mdshihab56/NodeMCU-open-source-IoT-Plant-Environment-Management-System-with-Web-Android-Desktop-interfaces./Images/WINDOWS APP UI.png

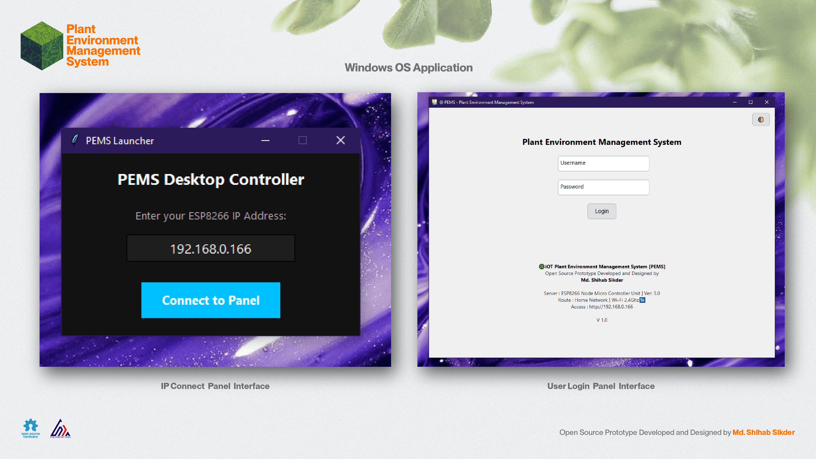
Images/WINDOWS APP UI.png
