mdshihab56/NodeMCU-open-source-IoT-Plant-Environment-Management-System-with-Web-Android-Desktop-interfaces./Images/TOP AND BOTTOM LATER PCB.png

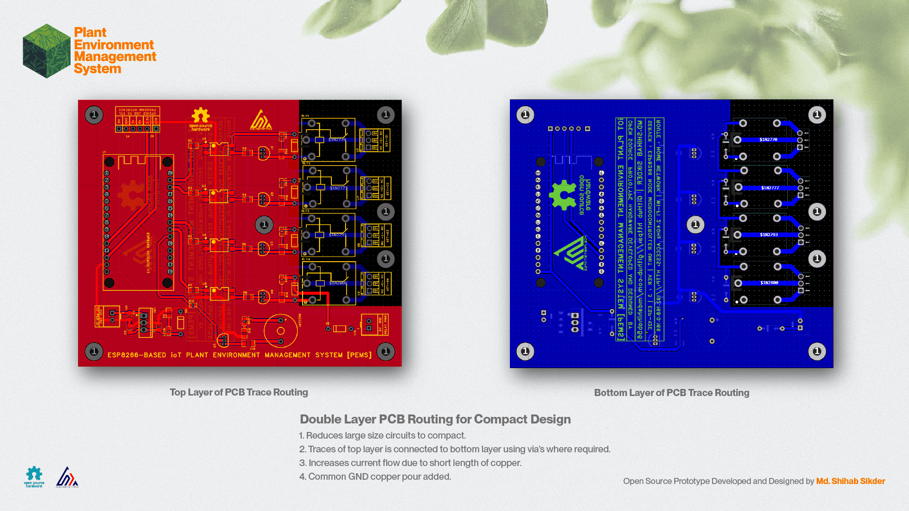
Images/TOP AND BOTTOM LATER PCB.png
