mdshihab56/NodeMCU-open-source-IoT-Plant-Environment-Management-System-with-Web-Android-Desktop-interfaces./README.md

# IoT Plant Environment Management System [PEMS]
PEMS Resperitory template

An ESP8266-based IoT automation prototype designed for smart plant environment control using a responsive web dashboard and real-time relay management.

## Overview

PEMS (Plant Environment Management System) is an open-source IoT project that combines embedded systems, web technologies, and environmental automation into a single platform.

The system allows users to control plant lighting, water supply, and environmental activation devices directly from a browser over Wi-Fi using an ESP8266 NodeMCU.
## Features
1. Login-protected Web Dashboard
2. Dark / Light Mode UI
3. ESP8266 Async Web Server
4. Dual Plant Light Control
5. Water Supply Control
6. Air Humidifier Control
7. Buzzer Feedback System
8. Responsive Minimal UI
9. Local Network Browser Access
10. Real-time Relay Switching

### Hardware
1. ESP8266 NodeMCU
2. 4-Channel opto-isolated Relay Design
3. Active Buzzer
4. Wi-Fi Network

### Programming Languages
1. Arduino C++
2. HTML
3. CSS
4. JavaScript
5. ESPAsyncWebServer Library

## Android Application
To improve accessibility and user experience, a dedicated Android application was developed for the PEMS ecosystem. The mobile application allows users to:
1. Connect directly to the ESP8266 local server
2. Access the control dashboard without manually typing the IP address
3. Control environmental modules remotely through a simplified mobile interface
4. Improve usability for daily plant monitoring operations
The Android application acts as a lightweight remote controller for the IoT system over a local Wi-Fi network.

## Windows Desktop Application
A standalone Windows desktop application was also developed using Python for desktop-based monitoring and control.

### Desktop Application Features
1. Quick access to the ESP8266 dashboard
2. Simplified desktop interaction
3. Faster local device management
4. Lightweight executable (.exe) application
5. No browser dependency required

## Programs used
1. Python
2. GUI-based desktop interface
3. Executable packaging for Windows systems
The desktop application was designed to provide a more convenient control environment for long-term monitoring and testing purposes.

## Multi-Platform Ecosystem
PEMS now supports multiple control platforms:

| Platform | Function |
|---|---|
| Web Dashboard | Browser-based Control |
| Android App | Mobile Access |
| Windows Application | Desktop Monitoring |
| ESP8266 Server | Core IoT Controller |
This creates a flexible multi-platform IoT ecosystem for smart environmental management.

## ESP8266 NodeMCU Pinout
ESP8266 PINOUT

## Circuit Schematic Diagram
SCHEMATICS

## Top and Bottom Layer PCB Designing
TOP AND BOTTOM LATER PCB

## PCB 2D View
PCB 2D VIEW

## USB to TTL Interface Header
USB TO TTL

## Web UI in Desktop Browser
WEB IP UI

## Web UI Activation Dashboard in Desktop Browser
WEB IP UI_ACTIVATION SYSTEM

## Windows App UI
WINDOWS APP UI

## Android Mobile App UI
MOBILE APP UI

## Web, PC, and Android App also in Black Theme by Toggle the Moon Icon
WEB, PC and MOBILE APP black theme UI

## Future Expansion Goals
Planned future developments include:
1. Real-time sensor analytics
2. Cloud connectivity
3. MQTT communication
4. Notification system
5. AI-assisted automation
6. Historical environmental data logging
7. Cross-platform synchronization
8. OTA firmware updates
9. Smart scheduling system
10. Mobile push notifications

# Project Vision
The goal of PEMS is to evolve into a scalable smart environmental management ecosystem capable of integrating embedded systems, automation, responsive web technologies, desktop software, and mobile applications into a unified IoT platform.
