mdshihab56/NodeMCU-open-source-IoT-Plant-Environment-Management-System-with-Web-Android-Desktop-interfaces./Android Apk/Preview/MOBILE APP UI.png

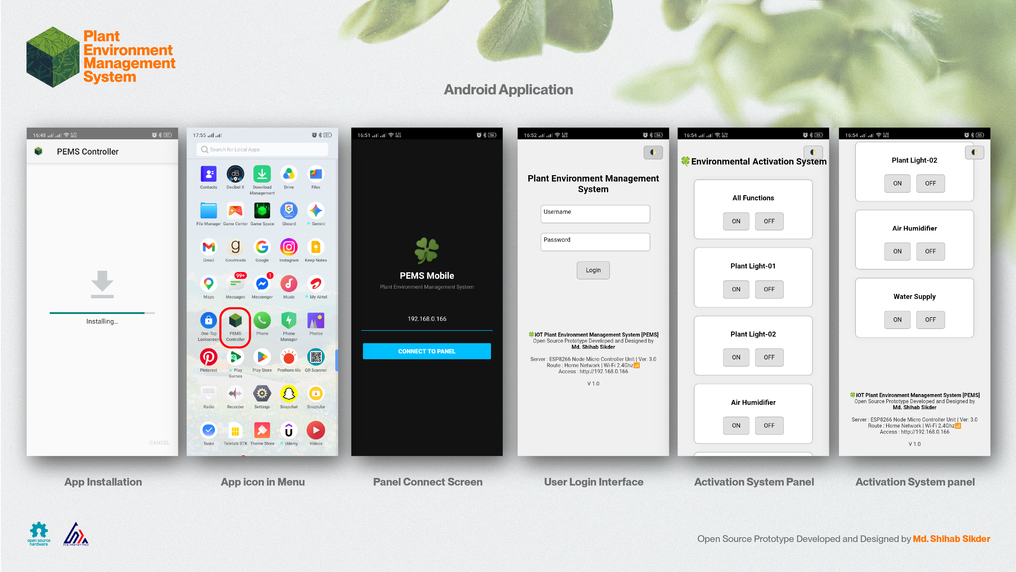
Android Apk/Preview/MOBILE APP UI.png
