mdshihab56/NodeMCU-open-source-IoT-Plant-Environment-Management-System-with-Web-Android-Desktop-interfaces./Circuit Schematic/SCHEMATICS.png

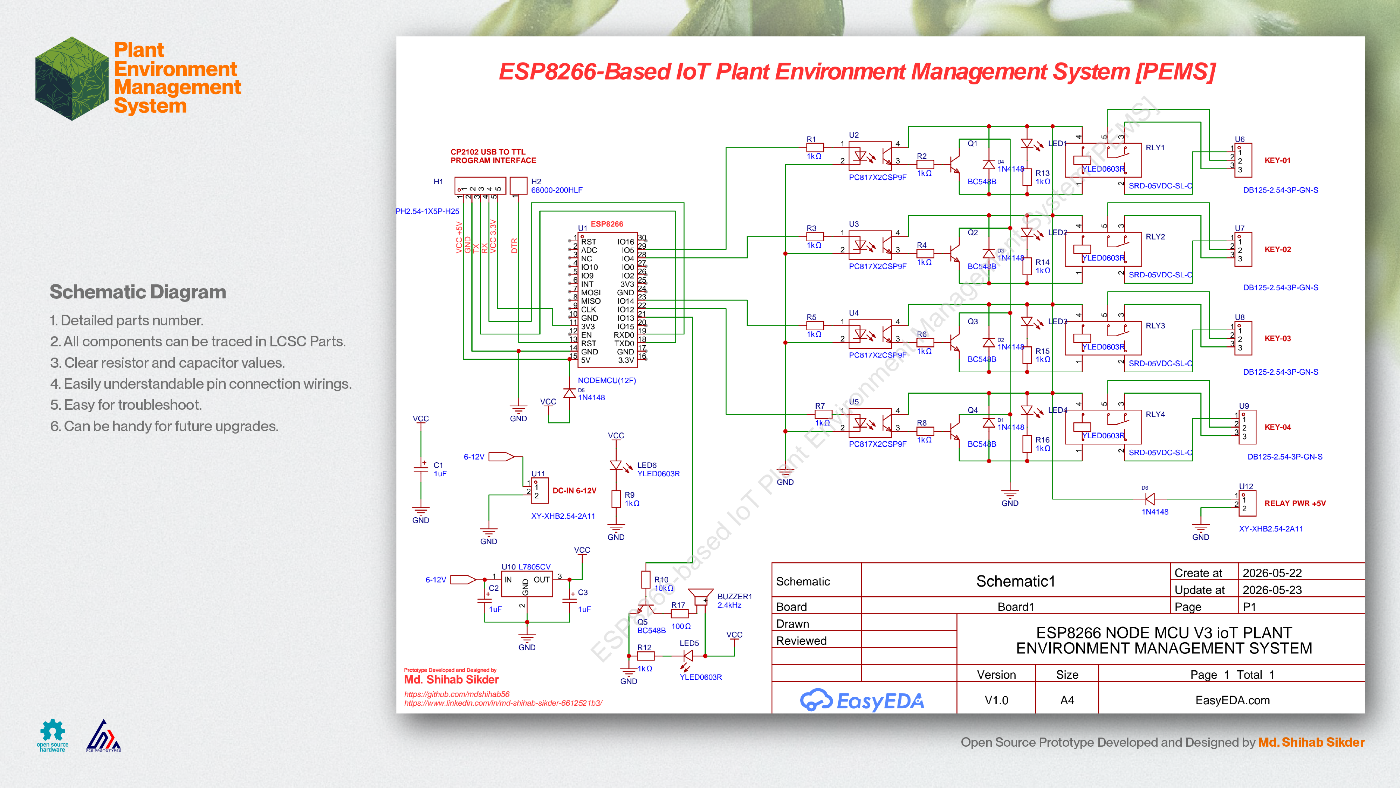
Circuit Schematic/SCHEMATICS.png
