mdshihab56/NodeMCU-open-source-IoT-Plant-Environment-Management-System-with-Web-Android-Desktop-interfaces./Images/ESP8266 PINOUT.png

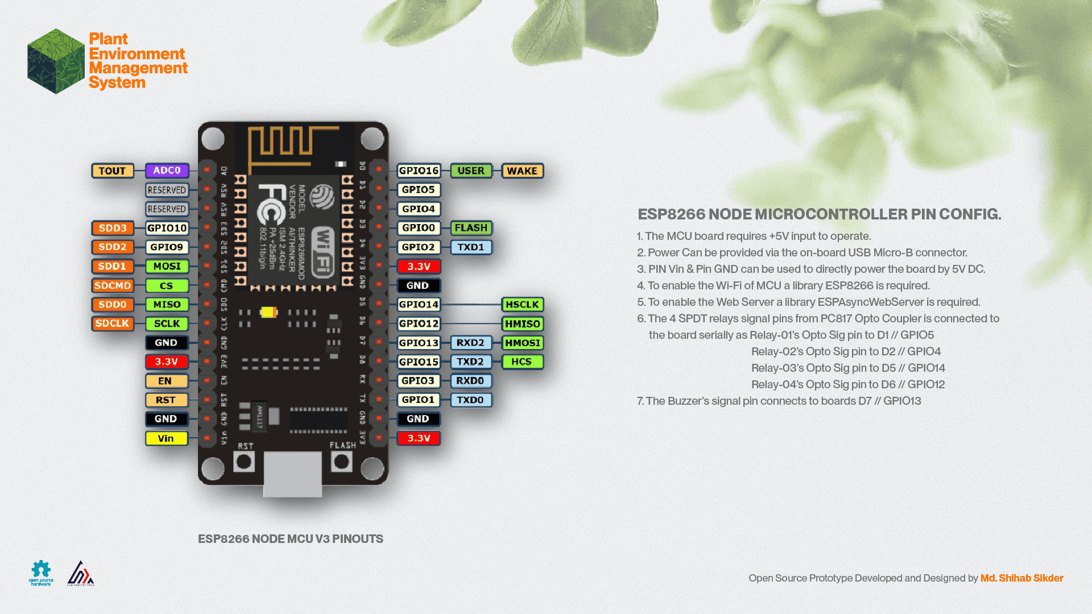
Images/ESP8266 PINOUT.png
