mdshihab56/NodeMCU-open-source-IoT-Plant-Environment-Management-System-with-Web-Android-Desktop-interfaces./Images/MOBILE APP UI.png

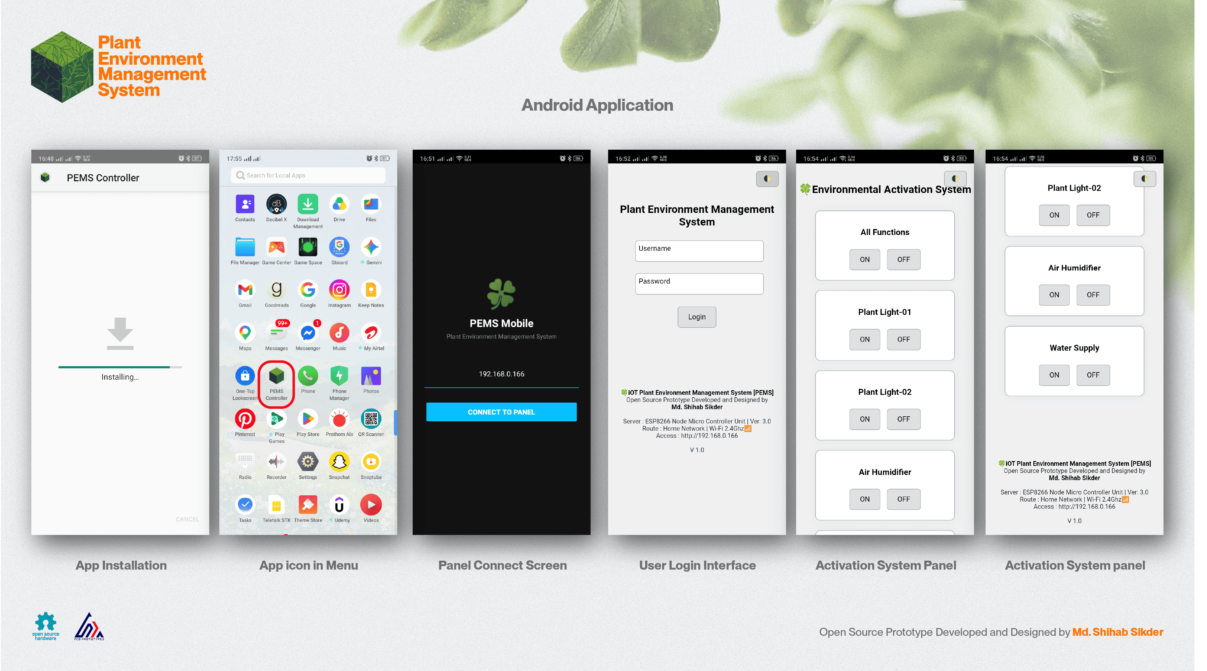
Images/MOBILE APP UI.png
