mdshihab56/NodeMCU-open-source-IoT-Plant-Environment-Management-System-with-Web-Android-Desktop-interfaces./Images/PCB 2D VIEW.png

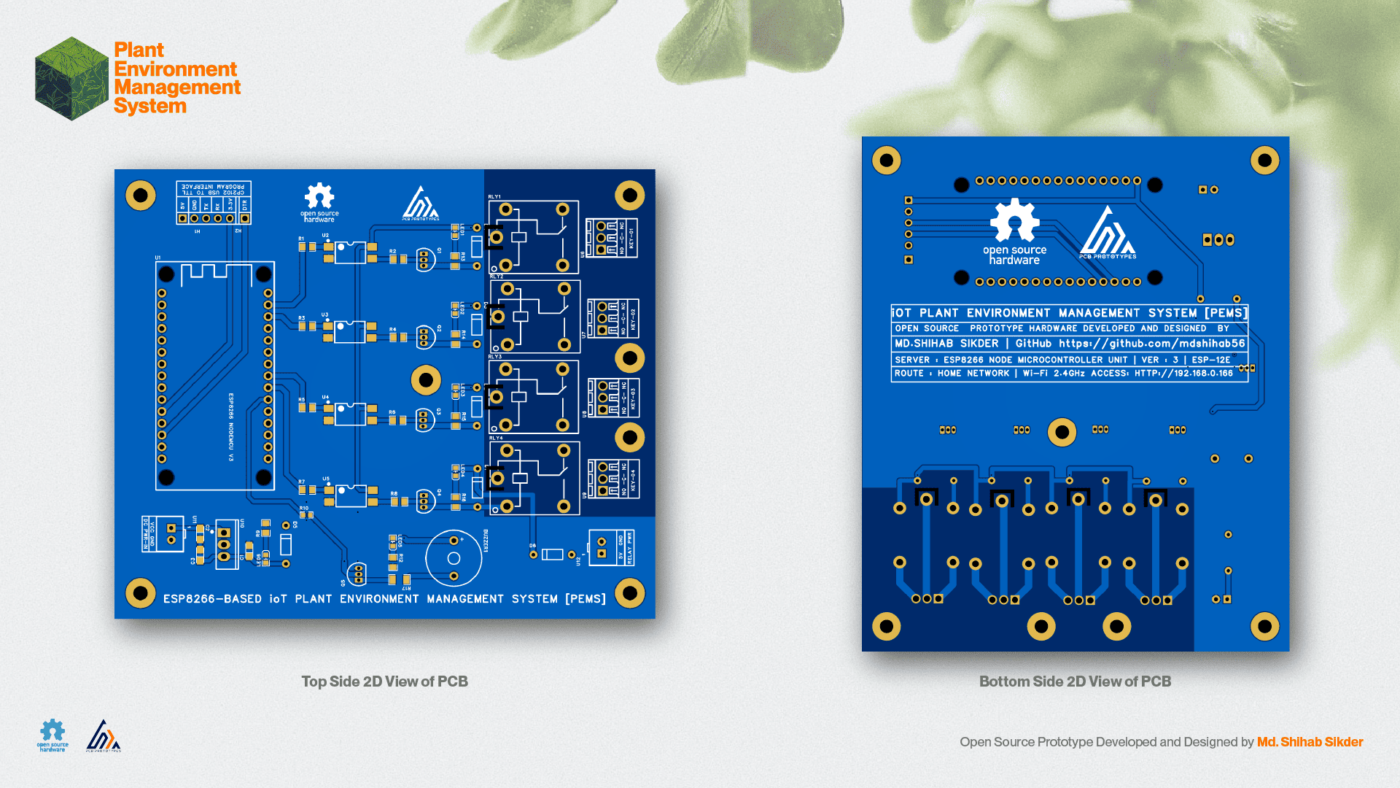
Images/PCB 2D VIEW.png
