mdshihab56/NodeMCU-open-source-IoT-Plant-Environment-Management-System-with-Web-Android-Desktop-interfaces./Images/WEB IP UI_ACTIVATION SYSTEM.png

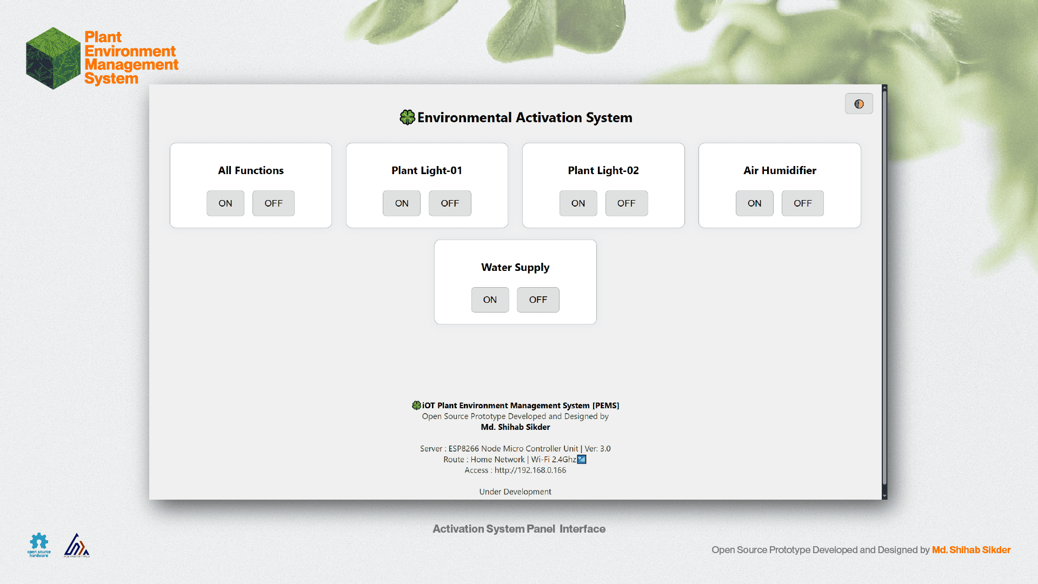
Images/WEB IP UI_ACTIVATION SYSTEM.png
