mdshihab56/NodeMCU-open-source-IoT-Plant-Environment-Management-System-with-Web-Android-Desktop-interfaces./Images/WEB, PC and MOBILE APP black theme UI.png

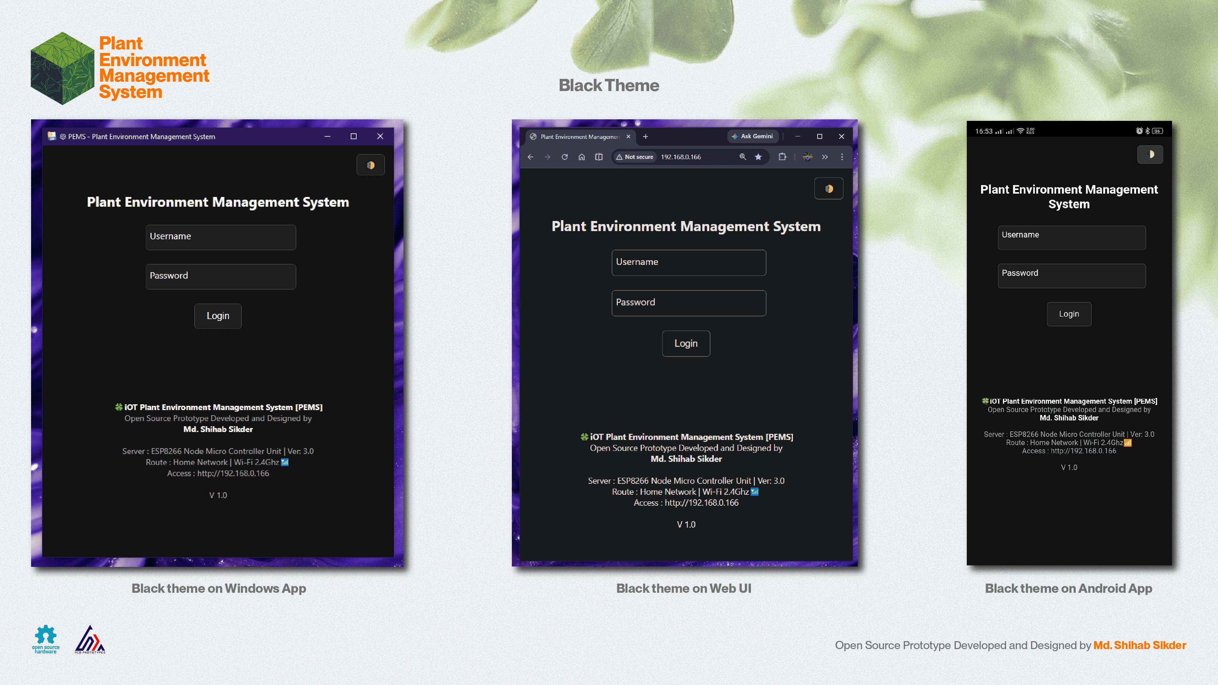
Images/WEB, PC and MOBILE APP black theme UI.png
